YakshithK/SimpleFlightController/hardware/production/bom.csv

Designator | Footprint | Quantity | Value | LCSC Part #
C1, C25, C26, C27 | 0402 | 4 | 1uF
C10, C15, C16, C17, C18, C20, C21, C22, C23, C24, C33 | 0402 | 11 | 100nF
C11, C12, C14, C34, C37 | 0805 | 5 | 22uF
C13 | 0402 | 1 | 10uF
C19, C36 | 0402 | 2 | 2.2uF
C2 | 0402 | 1 | 4.7uF
C28, C4, C6, C7, C8, C9 | 0805 | 6 | 10uF
C29, C30 | 0402 | 2 | 20pF
C3 | 0805 | 1 | 47nF
C31, C32 | 0402 | 2 | 6.8pF
C35 | 0402 | 1 | 0.1uF
C5 | 0805 | 1 | 47uF
D1 | 0402 | 1 | LED
J2 | TerminalBlock_Xinya_XY308-2.54-2P_1x02_P2.54mm_Horizontal | 1 | Screw_Terminal_01x02
J3, J4 | PinHeader_1x03_P2.54mm_Vertical | 2 | Conn_01x03
L1 | L2520 | 1 | DFE252012F-1ROM=P2 | C435392
L2 | IND-SMD_L4.0-W4.0-A | 1 | 1.5uH | C3033018
L3 | L0603 | 1 | FCM1608KF-601T03 | C141723
L4 | IND-SMD_L3.0-W3.0 | 1 | 5.6uH | C18236327
R1, R2 | 0201 | 2 | 5.1K
R10, R11, R12, R13, R14, R15, R16, R17, R18, R19, R20, R4, R7, R8, R9 | 0201 | 15 | 10K
R21 | 0402 | 1 | 100K
R22 | 0201 | 1 | 22.1K
R3 | 0201 | 1 | 30.1K
R5 | 0201 | 1 | 5.23K
R6 | 0201 | 1 | 383R
SW1, SW2 | SW-SMD_L3.9-W3.0-P4.45 | 2 | TS-1088-AR02016 | C720477
U1 | LGA-10_L2.0-W2.0-P0.50-TL_BMP580 | 1 | BMP580 | C22391138
U2 | VFQFPN-24_L4.0-W4.0-P0.50-BL-EP2.8 | 1 | BQ25883RGER | C544362
U3 | LGA-14_L3.0-W2.5-P0.50-TL | 1 | ICM-45686 | C22459454
U4 | TF-CARD-SMD_JBL-102010052 | 1 | JBL-102010052 | C49441431
U5 | SOT-23-6_L2.9-W1.6-P0.95-LS2.8-BL | 1 | LMR51430XDDCR | C5185863
U6 | LQFP-64_L10.0-W10.0-P0.50-LS12.0-BL | 1 | STM32F722RET6 | C118207
U8 | VQFN-HR-15_L3.0-W2.5-P0.50-BL_TPS63070RNMR | 1 | TPS630701RNMR | C2876599
USB1 | USB-C-SMD_TYPE-C-16PIN-2MD-073 | 1 | TYPE-C 16PIN 2MD | C2765186
X1 | CRYSTAL-SMD_4P-L3.2-W2.5-BL | 1 | X322525MOB4SI | C9006
X2 | FC-135R_L3.2-W1.5 | 1 | Q13FC1350000400 | C32346
