YakshithK/SimpleFlightController/hardware/SimpleFlightController.kicad_pcb

## KiCad design hardware/SimpleFlightController.kicad_pcb (2026-10-22)

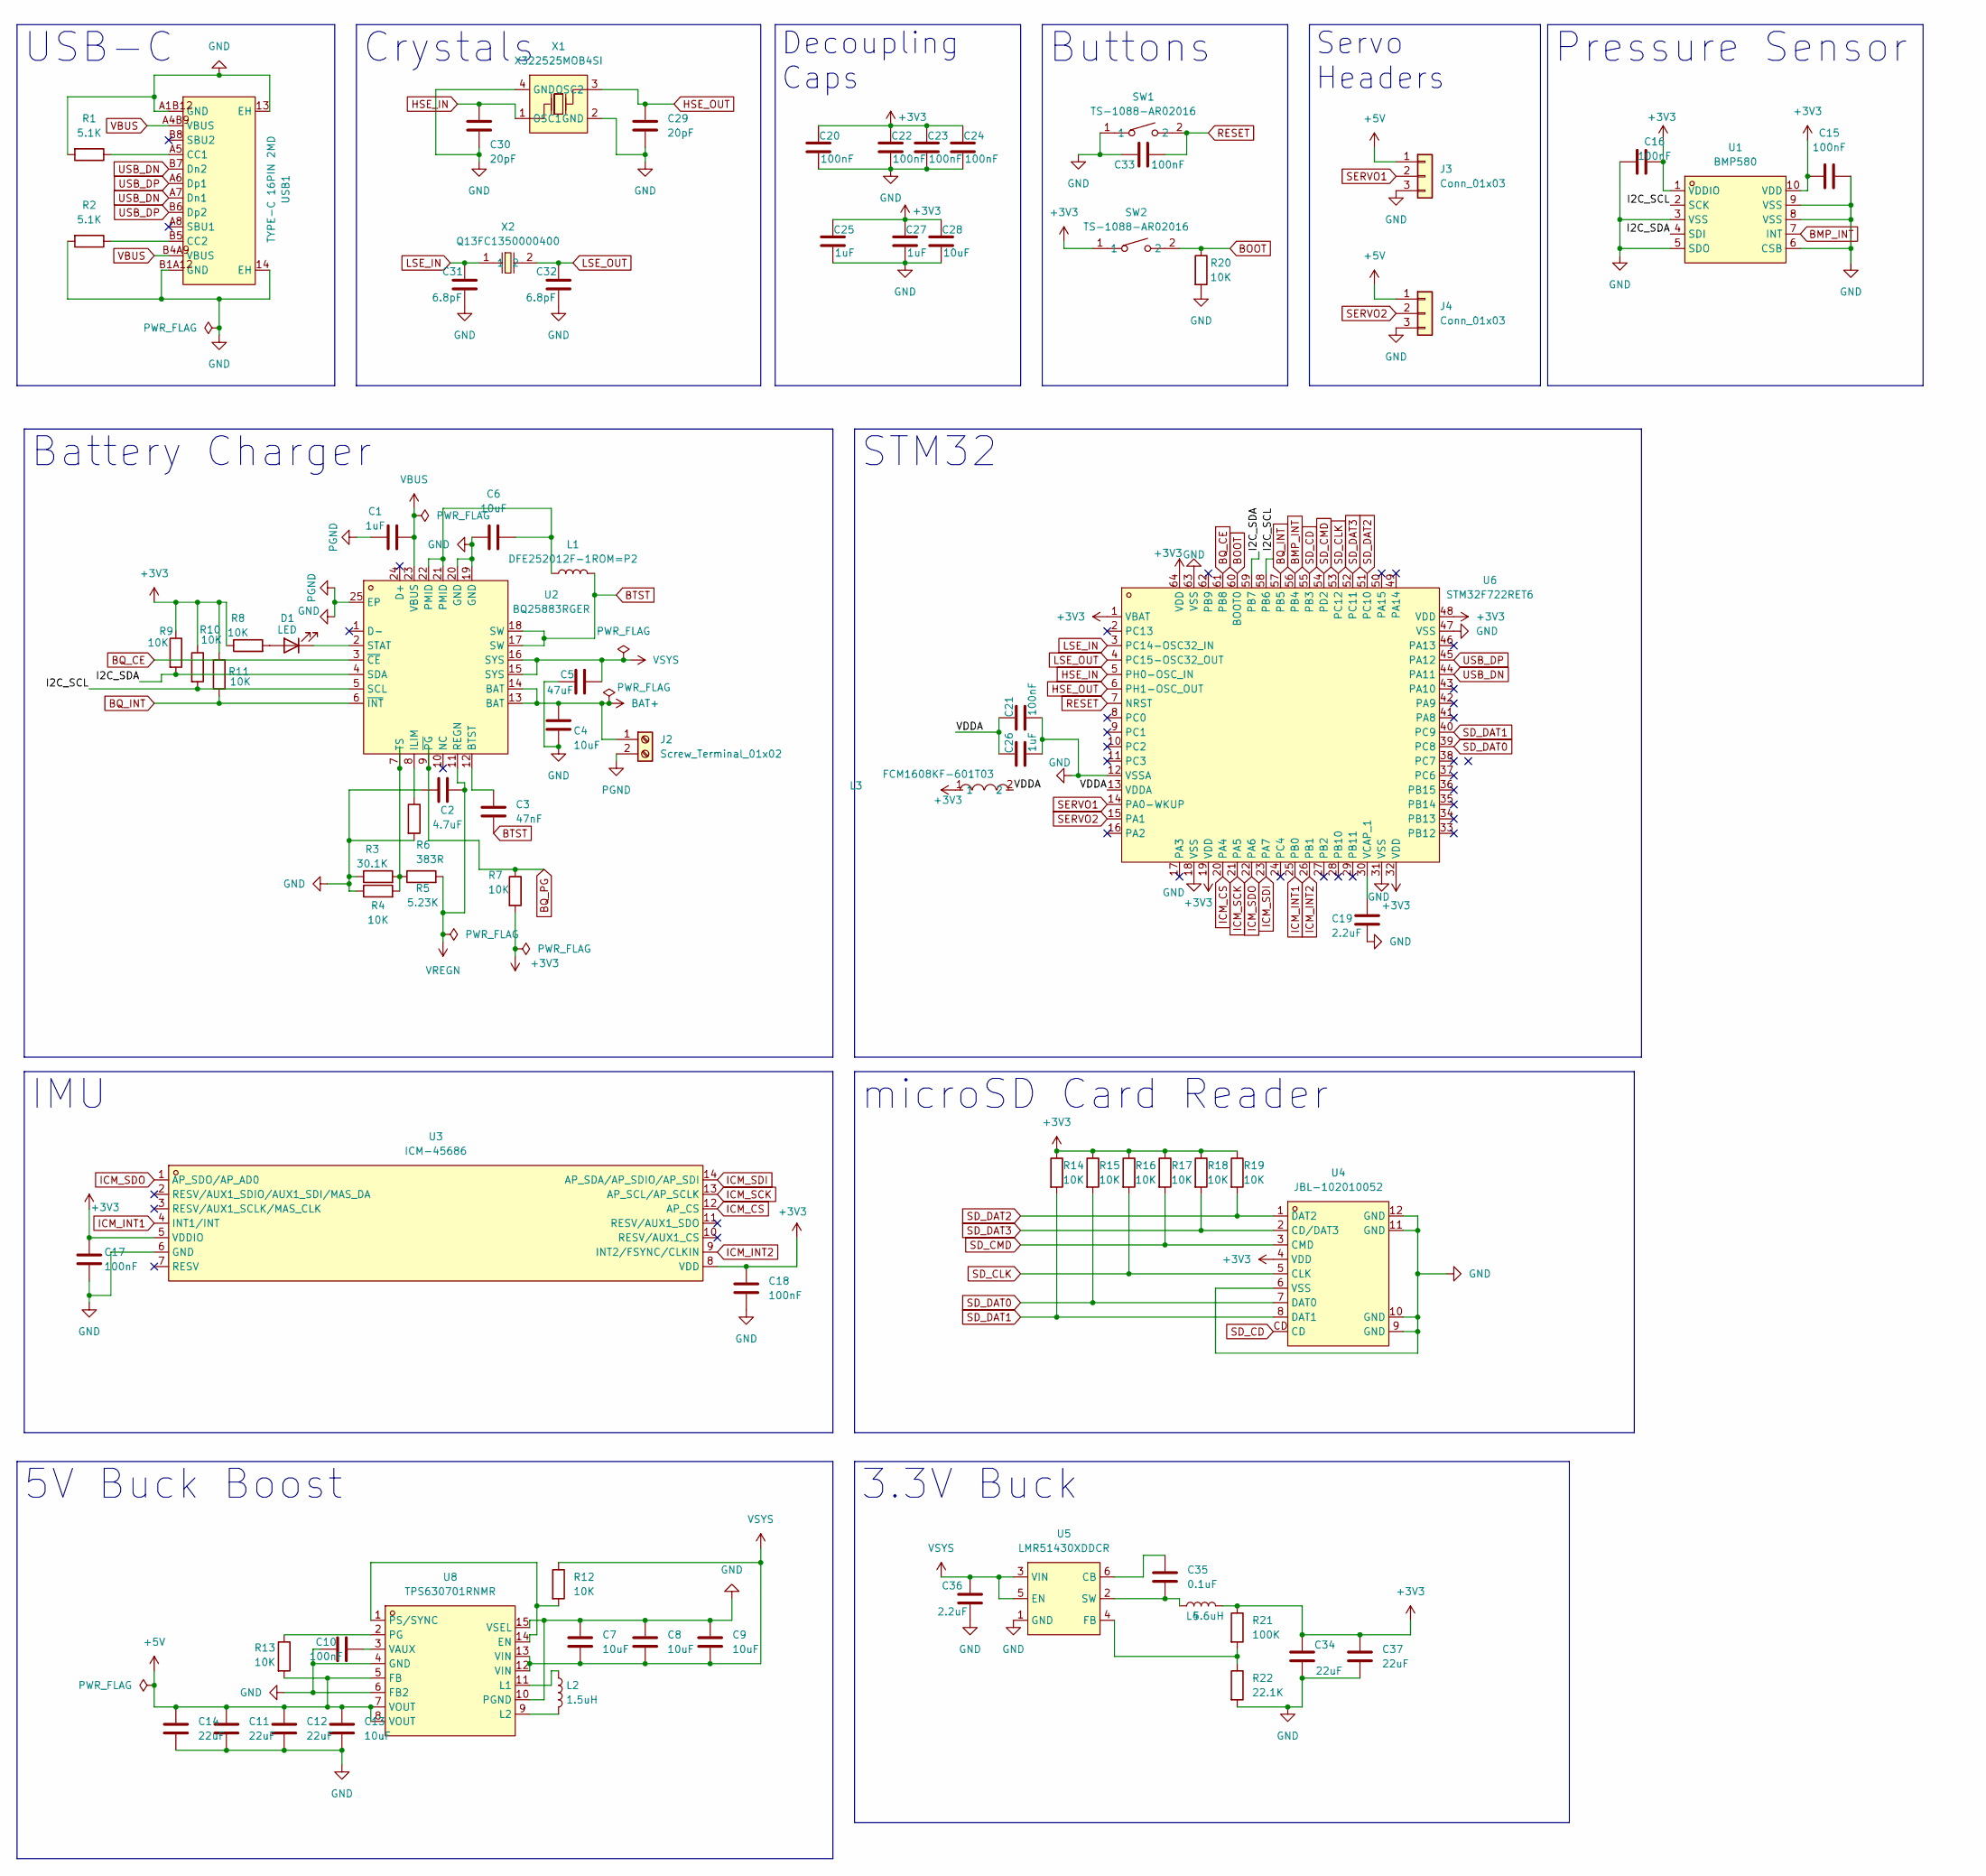
[picture p1: schematic SimpleFlightController.kicad_sch]

Parts:
C1, C25, C26, C27: 1uF; C_0402_1005Metric
C2: 4.7uF; C_0402_1005Metric
C3: 47nF; C_0805_2012Metric
C4, C6, C7, C8, C9, C28: 10uF; C_0805_2012Metric
C5: 47uF; C_0805_2012Metric
C10, C15, C16, C17, C18, C20, C21, C22, C23, C24, C33: 100nF; C_0402_1005Metric
C11, C12, C14, C34, C37: 22uF; C_0805_2012Metric
C13: 10uF; C_0402_1005Metric
C19, C36: 2.2uF; C_0402_1005Metric
C29, C30: 20pF; C_0402_1005Metric
C31, C32: 6.8pF; C_0402_1005Metric
C35: 0.1uF; C_0402_1005Metric
D1: LED; LED_0402_1005Metric
J2: Screw_Terminal_01x02; TerminalBlock_Xinya_XY308-2.54-2P_1x02_P2.54mm_Horizontal
J3, J4: Conn_01x03; PinHeader_1x03_P2.54mm_Vertical
L1: DFE252012F-1ROM=P2; L2520
L2: 1.5uH; IND-SMD_L4.0-W4.0-A
L3: FCM1608KF-601T03; L0603; MPN FCM1608KF-601T03; LCSC Part C141723
L4: 5.6uH; IND-SMD_L3.0-W3.0
R1, R2: 5.1K; R_0201_0603Metric
R3: 30.1K; R_0201_0603Metric
R4, R7, R8, R9, R10, R11, R12, R13, R14, R15, R16, R17, R18, R19, R20: 10K; R_0201_0603Metric
R5: 5.23K; R_0201_0603Metric
R6: 383R; R_0201_0603Metric
R21: 100K; R_0402_1005Metric
R22: 22.1K; R_0201_0603Metric
SW1, SW2: TS-1088-AR02016; SW-SMD_L3.9-W3.0-P4.45; MPN TS-1088-AR02016; LCSC Part C720477
U1: BMP580; LGA-10_L2.0-W2.0-P0.50-TL_BMP580; MPN BMP580; LCSC Part C22391138
U2: BQ25883RGER; VFQFPN-24_L4.0-W4.0-P0.50-BL-EP2.8; MPN BQ25883RGER; LCSC Part C544362
U3: ICM-45686; LGA-14_L3.0-W2.5-P0.50-TL; MPN ICM-45686; LCSC Part C22459454
U4: JBL-102010052; TF-CARD-SMD_JBL-102010052; MPN JBL-102010052; LCSC Part C49441431
U5: LMR51430XDDCR; SOT-23-6_L2.9-W1.6-P0.95-LS2.8-BL; MPN LMR51430XDDCR; LCSC Part C5185863
U6: STM32F722RET6; LQFP-64_L10.0-W10.0-P0.50-LS12.0-BL; MPN STM32F722RET6; LCSC Part C118207
U8: TPS630701RNMR; VQFN-HR-15_L3.0-W2.5-P0.50-BL_TPS63070RNMR; MPN TPS630701RNMR; LCSC Part C2876599
USB1: TYPE-C 16PIN 2MD; USB-C-SMD_TYPE-C-16PIN-2MD-073; MPN TYPE-C 16PIN 2MD(073); LCSC Part C2765186
X1: X322525MOB4SI; CRYSTAL-SMD_4P-L3.2-W2.5-BL; MPN X322525MOB4SI; LCSC Part C9006
X2: Q13FC1350000400; FC-135R_L3.2-W1.5; MPN Q13FC13500004; LCSC Part C32346

Connections:
+3V3: C15.1, C16.2, C17.1, C18.1, C20.1, C22.1, C23.1, C24.1, C25.1, C27.1, C28.1, C34.1, C37.1, L3.1, L4.2, R7.2, R8.1, R9.1, R10.1, R11.1, R14.1, R15.1, R16.1, R17.1, R18.1, R19.1, R21.1, SW2.1, U1.1 (VDDIO), U1.10 (VDD), U3.5 (VDDIO), U3.8 (VDD), U4.4 (VDD), U6.1 (VBAT), U6.19 (VDD), U6.32 (VDD), U6.48 (VDD), U6.64 (VDD)
+5V: C11.1, C12.1, C13.1, C14.1, J3.1, J4.1, R13.2, U8.5 (FB), U8.7 (VOUT), U8.8 (VOUT)
/I2C_SCL: R10.2, U1.2 (SCK), U2.5 (SCL), U6.58 (PB6)
/I2C_SDA: R9.2, U1.4 (SDI), U2.4 (SDA), U6.59 (PB7)
/VDDA: C21.1, C26.1, L3.2, U6.13 (VDDA)
BAT+: C4.1, J2.1, U2.13 (BAT), U2.14 (BAT)
BMP_INT: U1.7 (INT), U6.56 (PB4)
BOOT: R20.1, SW2.2, U6.60 (BOOT0)
BQ_CE: U2.3 (~CE), U6.61 (PB8)
BQ_INT: R11.2, U2.6 (~INT), U6.57 (PB5)
BQ_PG: R7.1, U2.9 (~PG)
BTST: C3.2, L1.2, U2.17 (SW), U2.18 (SW)
GND: C1.1, C2.1, C4.2, C5.1, C6.1, C7.1, C8.1, C9.1, C10.1, C11.2, C12.2, C13.2, C14.2, C15.2, C16.1, C17.2, C18.2, C19.2, C20.2, C21.2, C22.2, C23.2, C24.2, C25.2, C26.2, C27.2, C28.2, C29.2, C30.2, C31.2, C32.2, C33.2, C34.2, C36.2, C37.2, J2.2, J3.3, J4.3, R1.2, R2.2, R3.1, R4.1, R6.2, R20.2, R22.2, SW1.1, U1.3 (VSS), U1.5 (SDO), U1.6 (CSB), U1.8 (VSS), U1.9 (VSS), U2.19 (GND), U2.20 (GND), U2.25 (EP), U3.6 (GND), U4.6 (VSS), U4.9 (GND), U4.10 (GND), U4.11 (GND), U4.12 (GND), U5.1 (GND), U6.12 (VSSA), U6.18 (VSS), U6.31 (VSS), U6.47 (VSS), U6.63 (VSS), U8.4 (GND), U8.6 (FB2), U8.10 (PGND), U8.15 (VSEL), USB1.13 (EH), USB1.14 (EH), USB1.A1B12 (GND), USB1.B1A12 (GND), X1.2 (GND), X1.4 (GND)
HSE_IN: C30.1, U6.5 (PH0-OSC_IN), X1.1 (OSC1)
HSE_OUT: C29.1, U6.6 (PH1-OSC_OUT), X1.3 (OSC2)
ICM_CS: U3.12 (AP_CS), U6.20 (PA4)
ICM_INT1: U3.4 (INT1/INT), U6.25 (PB0)
ICM_INT2: U3.9 (INT2/FSYNC/CLKIN), U6.26 (PB1)
ICM_SCK: U3.13 (AP_SCL/AP_SCLK), U6.21 (PA5)
ICM_SDI: U3.14 (AP_SDA/AP_SDIO/AP_SDI), U6.23 (PA7)
ICM_SDO: U3.1 (AP_SDO/AP_AD0), U6.22 (PA6)
LSE_IN: C31.1, U6.3 (PC14-OSC32_IN), X2.1
LSE_OUT: C32.1, U6.4 (PC15-OSC32_OUT), X2.2
unnamed: C6.2, L1.1, U2.21 (PMID), U2.22 (PMID)
unnamed: D1.2 (A), R8.2
unnamed: D1.1 (K), U2.2 (STAT)
unnamed: C3.1, U2.12 (BTST)
unnamed: R6.1, U2.8 (ILIM)
unnamed: R3.2, R4.2, R5.1, U2.7 (TS)
unnamed: C35.1, U5.6 (CB)
unnamed: R21.2, R22.1, U5.4 (FB)
unnamed: C35.2, L4.1, U5.2 (SW)
unnamed: C19.1, U6.30 (VCAP_1)
unnamed: R12.2, U8.1 (PS/SYNC), U8.14 (EN)
unnamed: L2.1, U8.11 (L1)
unnamed: L2.2, U8.9 (L2)
unnamed: R13.1, U8.2 (PG)
unnamed: C10.2, U8.3 (VAUX)
unnamed: R1.1, USB1.A5 (CC1)
unnamed: R2.1, USB1.B5 (CC2)
RESET: C33.1, SW1.2, U6.7 (NRST)
SD_CD: U4.CD, U6.55 (PB3)
SD_CLK: R16.2, U4.5 (CLK), U6.53 (PC12)
SD_CMD: R17.2, U4.3 (CMD), U6.54 (PD2)
SD_DAT0: R15.2, U4.7 (DAT0), U6.39 (PC8)
SD_DAT1: R14.2, U4.8 (DAT1), U6.40 (PC9)
SD_DAT2: R19.2, U4.1 (DAT2), U6.51 (PC10)
SD_DAT3: R18.2, U4.2 (CD/DAT3), U6.52 (PC11)
SERVO1: J3.2, U6.14 (PA0-WKUP)
SERVO2: J4.2, U6.15 (PA1)
USB_DN: U6.44 (PA11), USB1.A7 (Dn1), USB1.B7 (Dn2)
USB_DP: U6.45 (PA12), USB1.A6 (Dp1), USB1.B6 (Dp2)
VBUS: C1.2, U2.23 (VBUS), USB1.A4B9 (VBUS), USB1.B4A9 (VBUS)
VREGN: C2.2, R5.2, U2.11 (REGN)
VSYS: C5.2, C7.2, C8.2, C9.2, C36.1, R12.1, U2.15 (SYS), U2.16 (SYS), U5.3 (VIN), U5.5 (EN), U8.12 (VIN), U8.13 (VIN)

Notes on the sheet:
3.3V Buck
Crystals
STM32
Pressure Sensor
Battery Charger
Servo Headers
microSD Card Reader
Buttons
USB-C
IMU
Decoupling Caps
5V Buck Boost

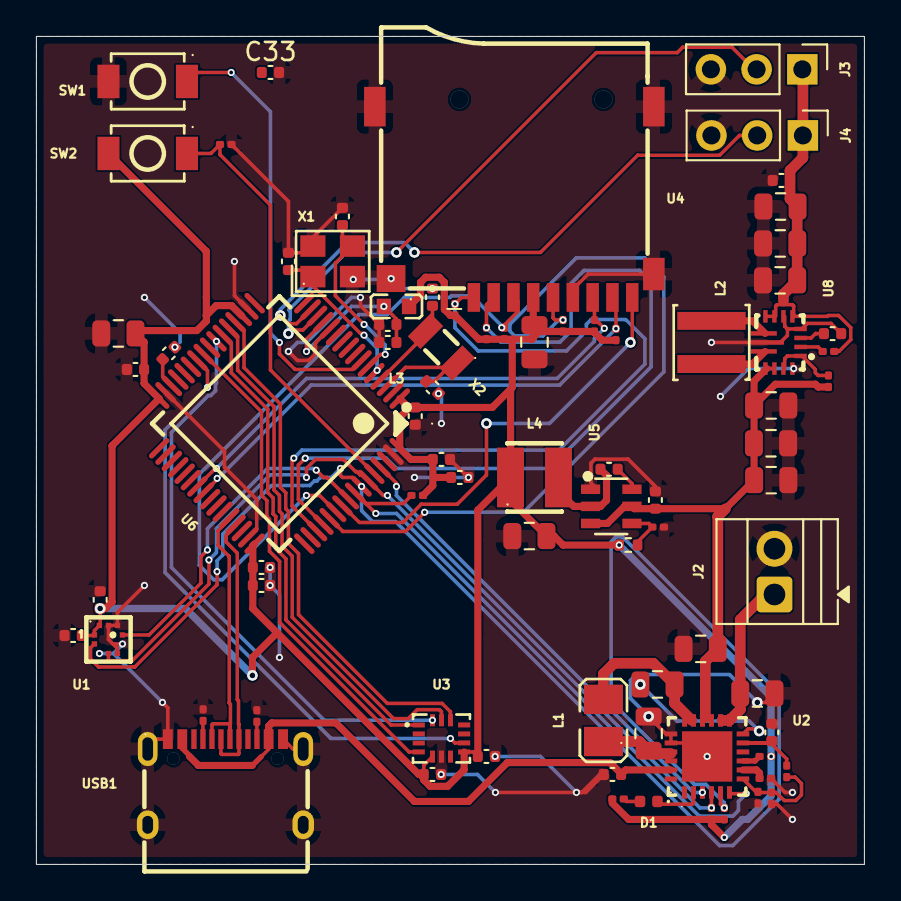
[picture p2: board SimpleFlightController.kicad_pcb from above]

Board: 2 copper layers, 46.0 x 46.0 mm, 79 parts (0 on the bottom side), 55 nets.
